andrey-belokon/NanoVFO_3/doc/as5600_encoder.png

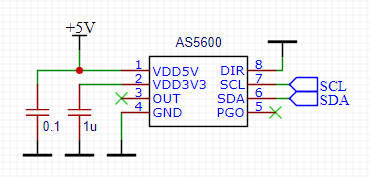
doc/as5600_encoder.png
