andrey-belokon/NanoVFO_3/doc/img/nanovfo3.2.new.jpg

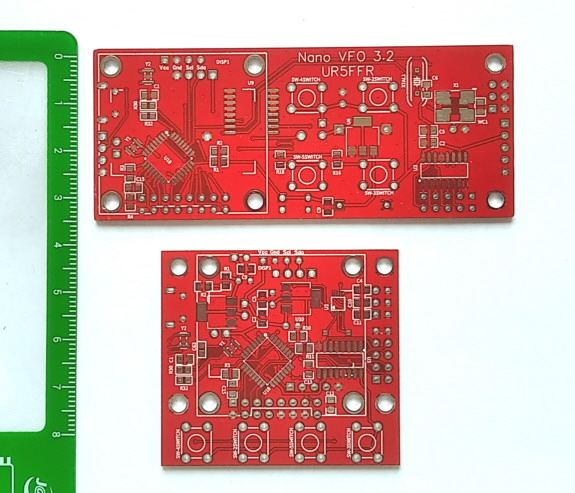
doc/img/nanovfo3.2.new.jpg
