andrey-belokon/NanoVFO_3/doc/img/nanovfo3_back.jpg

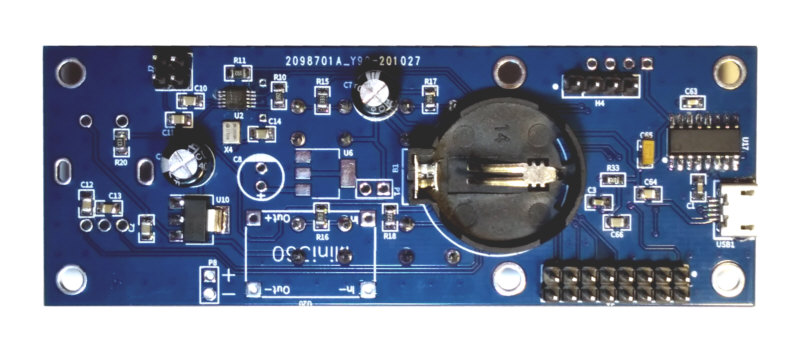
doc/img/nanovfo3_back.jpg
