andrey-belokon/NanoVFO_3/doc/img/nanovfo3_square_band_menu.jpg

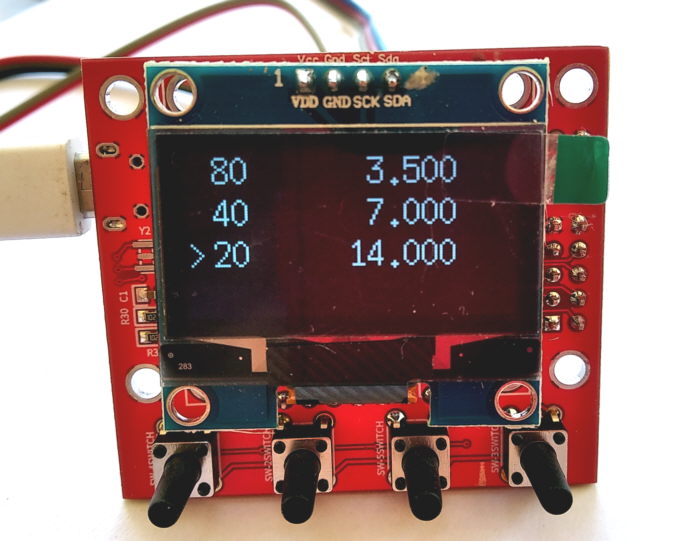
doc/img/nanovfo3_square_band_menu.jpg
