andrey-belokon/NanoVFO_3/doc/img/nanovfo3_square_pcb.jpg

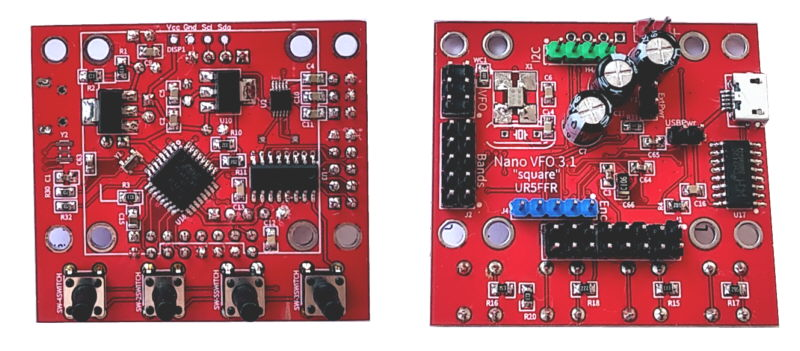
doc/img/nanovfo3_square_pcb.jpg
