andrey-belokon/NanoVFO_3/doc/img/nanovfo3_top.jpg

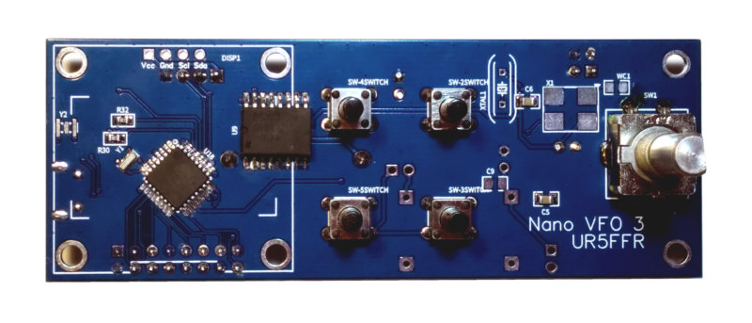
doc/img/nanovfo3_top.jpg
