andrey-belokon/NanoVFO_3/doc/img/nanovfo31_front.jpg

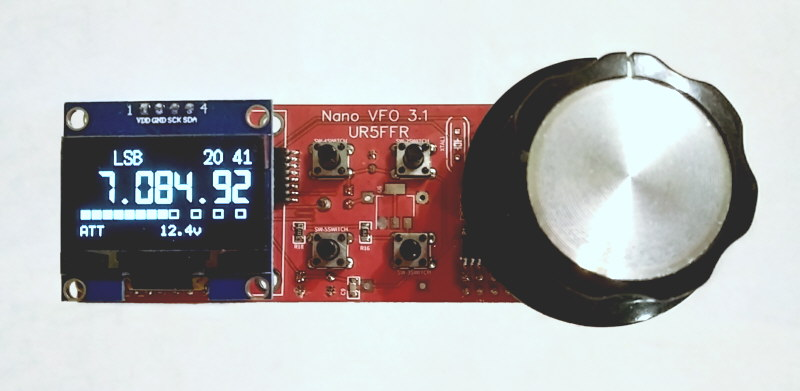
doc/img/nanovfo31_front.jpg
