andrey-belokon/NanoVFO_3/doc/Schematic_Nano VFO 3 SuperLED 2.png

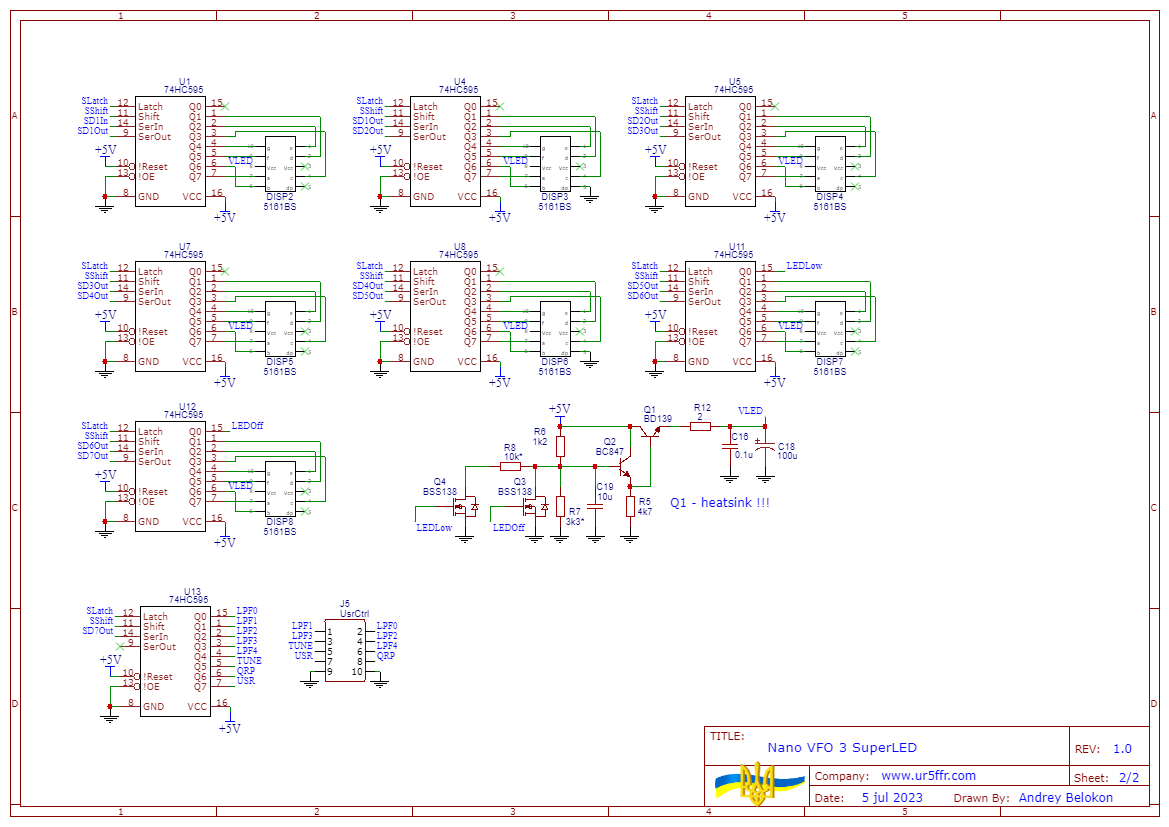
doc/Schematic_Nano VFO 3 SuperLED 2.png
