andrey-belokon/NanoVFO_3/doc/Schematic_Nano-VFO-3.1-square.png

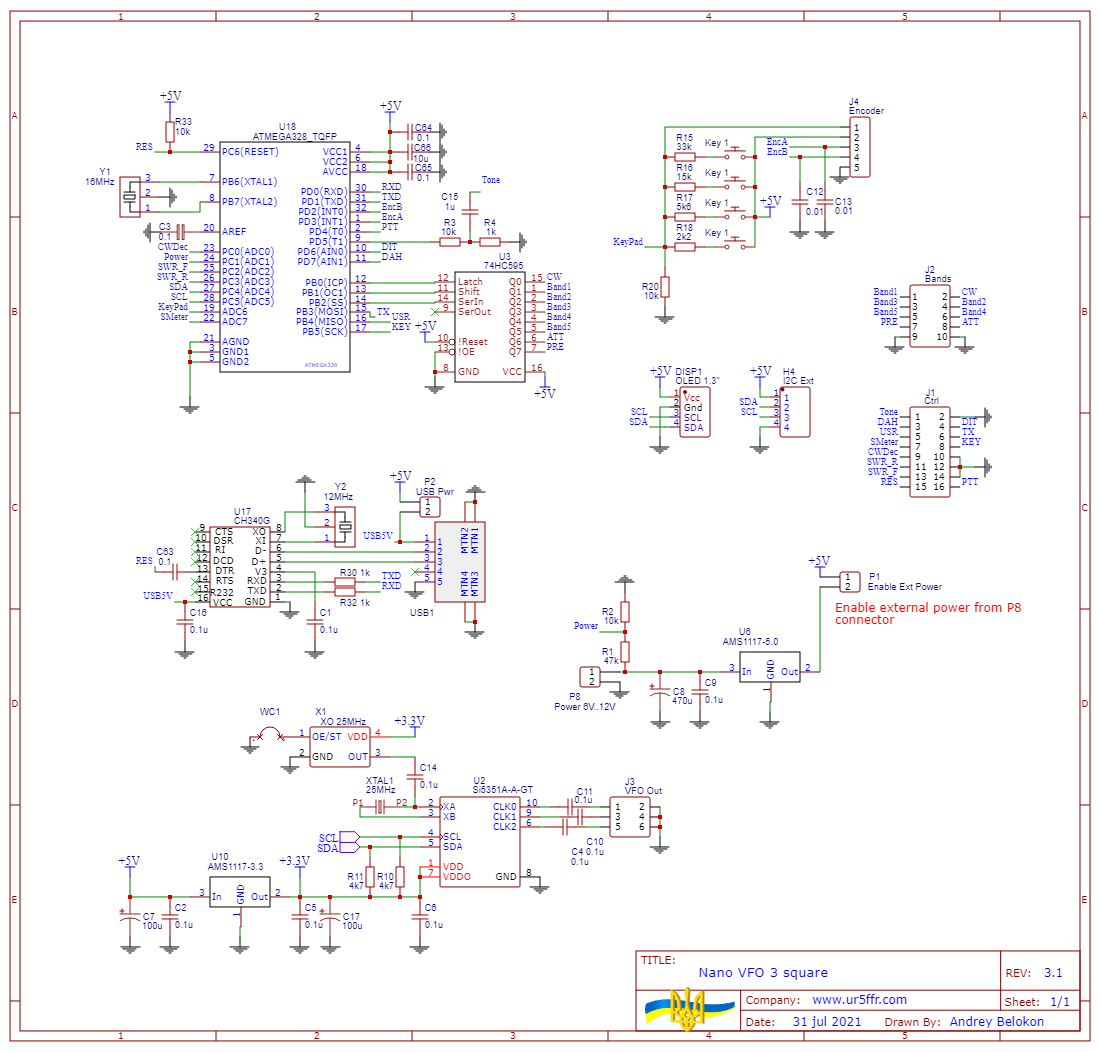
doc/Schematic_Nano-VFO-3.1-square.png
