andrey-belokon/NanoVFO_3/doc/Schematic_Nano-VFO-3.png

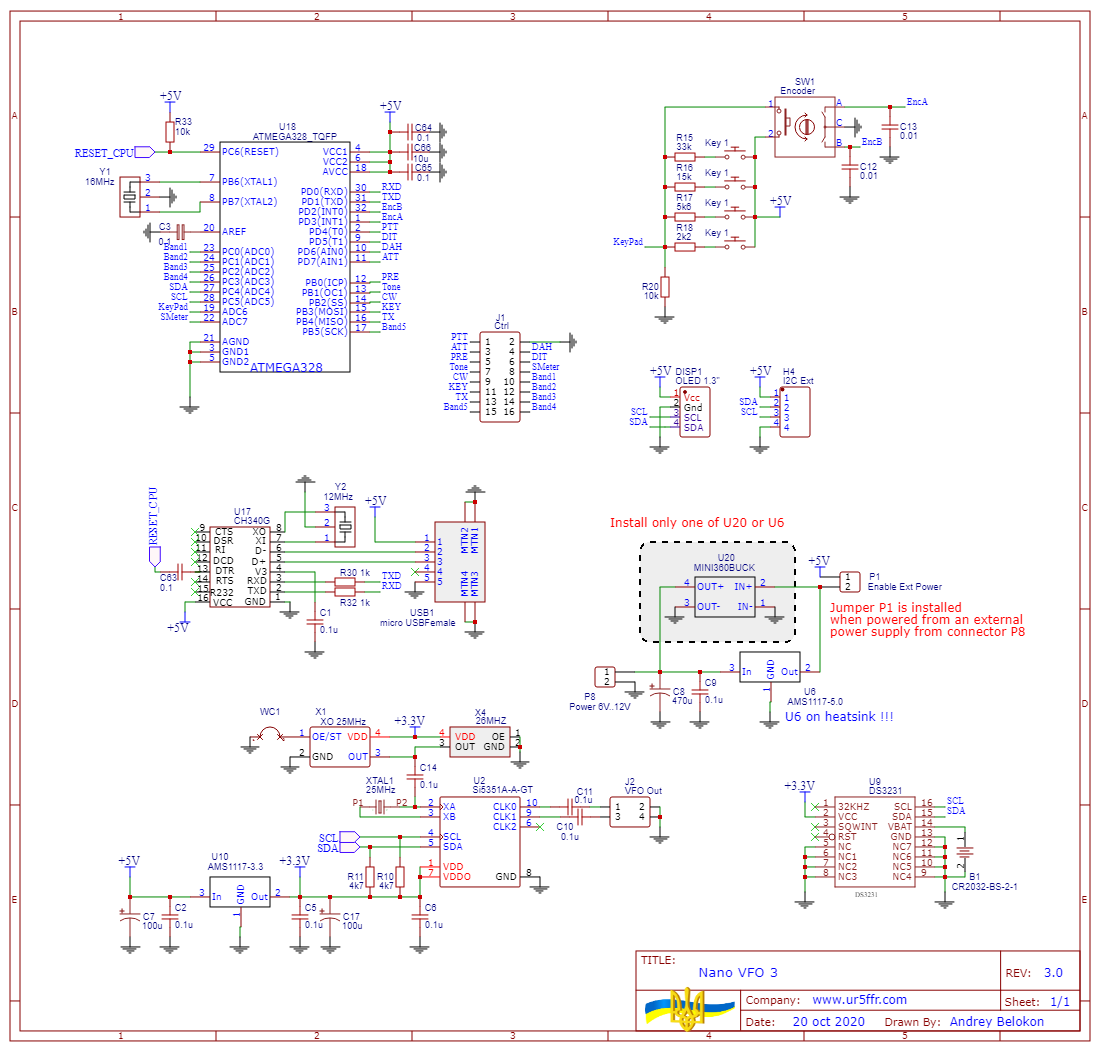
doc/Schematic_Nano-VFO-3.png
