andrey-belokon/NanoVFO_3/(threads)

Thread 1 (2022-12-13):

display doesn't start up

co6egm, 2022-12-13:
Hello! I'm trying to duplicate this VFO, but I noticed the display doesn't start on its own when unpower/power back on. I tried to upload an example just to initiate the display, then upload your sketch, and it works because the display is already initiated, but the issue appears when I shut down and power my Arduino back on. My test setup is just an arduino nano and the display properly wired.

co6egm, 2022-12-13:
solved after checking HW config file

Closed 2022-12-13.

Thread 2 (2023-11-17):

FT817 cat mode not working on WSTJ-X

rampa069, 2023-11-17:
FT817 is not working on WSTJ-X. Kenwood mode works ok, but cannot have SWR reading and kenwood mode (some extra bytes needed)

```
 Error Hamlib:
rig.c(1451):rig_open returning2(0)
 2:rig.c(3053):rig_get_vfo entered
rig_get_vfo: cache miss age=16059ms
 rig.c(3095) trace
ft817_get_vfo: called
ft817_read_eeprom: called
write_block(): TX 5 bytes, method=1
0000    00 55 00 00 bb                                      .U...   
read_block_generic called, direct=1
read_block_generic(1180): retrying read timeout 1/1 timeout=3000ms
0000    00                                                  .       
read_block_generic(): Timed out 6.46421 seconds after 1 chars, direct=1
Protocol error
)
 2:rig_get_vfo: elapsed=6053ms
 2:rig.c(3118):rig_get_vfo returning(-8) Protocol error

Protocol error
Protocol error
 mientras testing getting current VFO
```
