andrey-belokon/NanoVFO_3/doc/Schematic_Nano VFO 3 SuperLED.pdf

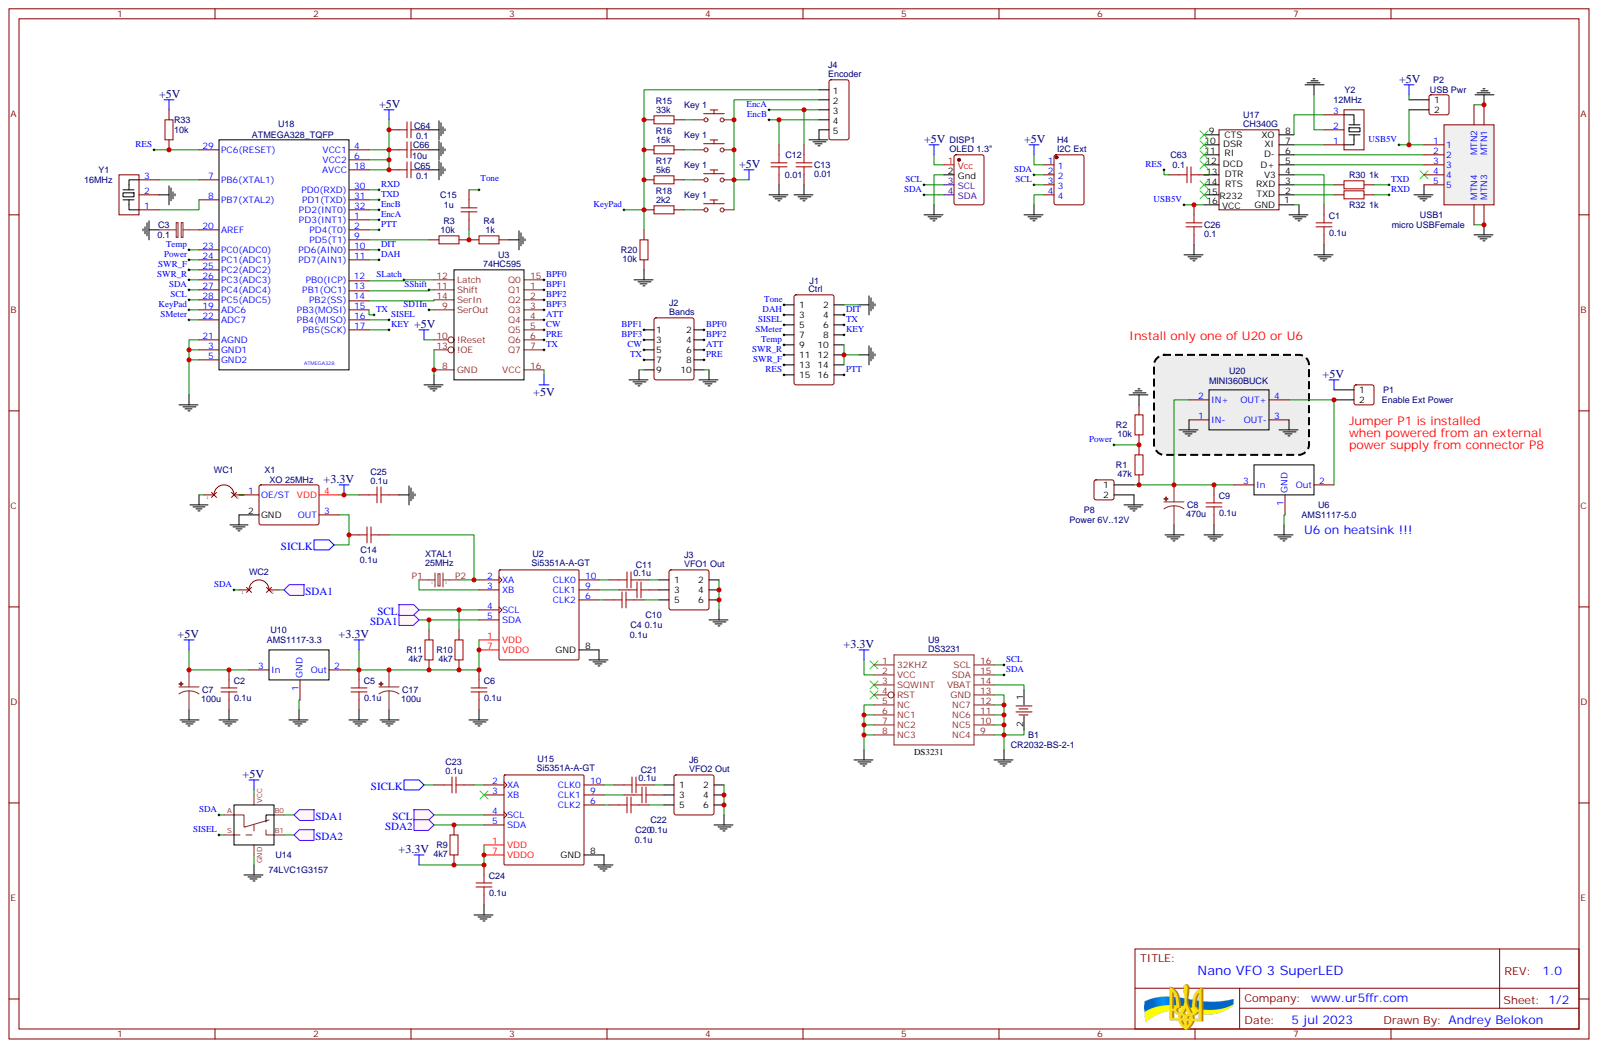
[picture p19: page 1]

Install only one of U20 or U6

Jumper P1 is installed
when powered from an external
power supply from connector P8

Drawn By: Andrey Belokon

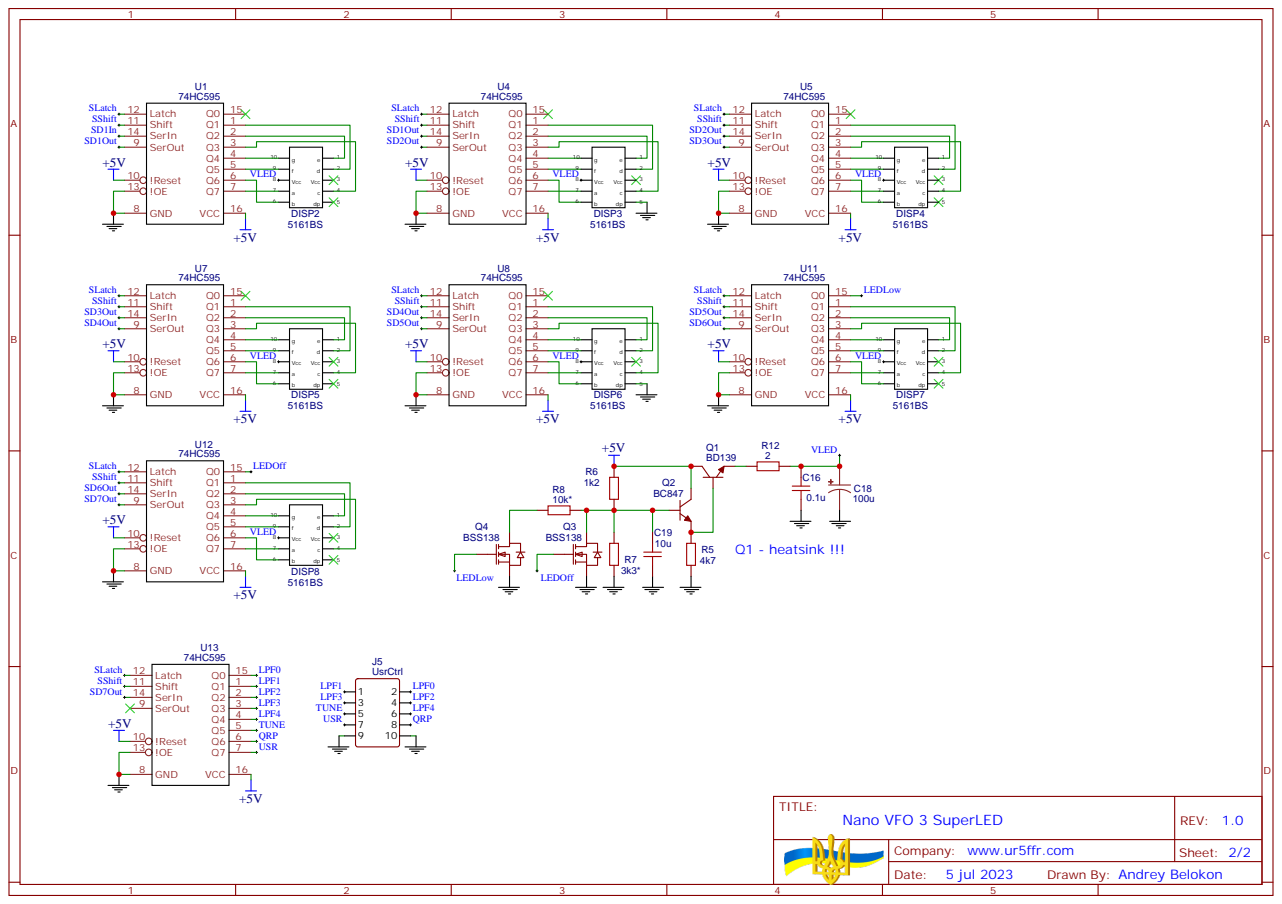
[picture p20: page 2]

Drawn By: Andrey Belokon
