andrey-belokon/NanoVFO_3/doc/Schematic_Nano-VFO-3.1-square.pdf

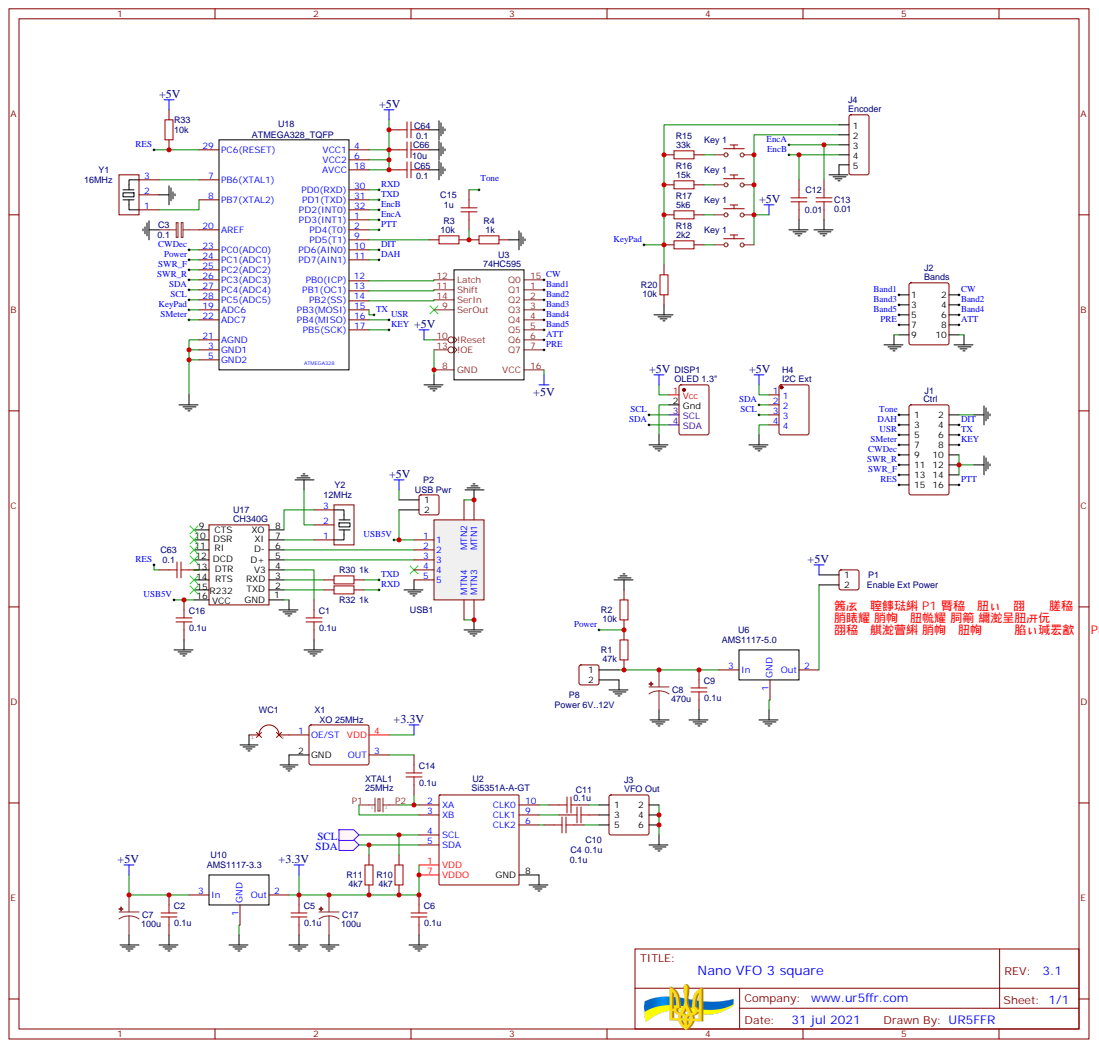
[picture p21: page 1]

Enable Ext Power
䇴㕄е䏄䭄琺䌀 P1 䐴䅄␰䏔ぃ␻䎄㉃е䐤䅄
䏴䁃耀 䏴㡄␰䏔㡃耀 䏤䈀 䌤㵃呈䏔㕃㐾
