andrey-belokon/NanoVFO_3/NanoVFO3/disp_OLED128x64.h

#ifndef DISP_OLED12864_H
#define DISP_OLED12864_H

#include <Arduino.h>
#include "TRX.h"

class Display_OLED128x64 {
  public:
	  void setup();
    // 1..15
    void setBright(uint8_t brightness);
	  void Draw(TRX& trx);
    void DrawItemEdit(PGM_P text, int value);
    void DrawItemValue(int value);
    void DrawItems(PGM_P* text, uint8_t selected);
    void DrawItemsValue(byte idx, int value, PGM_P sfx);
    void DrawSelected(uint8_t selected);
    void DrawFreqItems(TRX& trx, uint8_t idx, uint8_t selected);
    void DrawSMeterItems(PGM_P* text, const int* vals, uint8_t selected);
    #ifdef ENABLE_SWR_SENSOR
      void DrawSWRMeasureInit();
      void DrawSWRMeasure(int fval, int rval, int pwr = 0);
      void DrawSWRItemRaw(int fval, int rval);
    #endif
    void DrawText(bool visible, PGM_P text, uint8_t y);
    void BlinkText(PGM_P text);
    #ifdef ENABLE_INTERNAL_CWKEY
      void DrawCWBuf(TRX& trx);
    #endif
    #ifdef HARDWARE_3_1
      void DrawVCC(int rawdata, int vcc);
    #endif
    void clear();
};

#endif
