andrey-belokon/NanoVFO_3/(commit log)

2020-11-24 неточности в номиналах схемы
2020-11-24 не выставлялась частота в CAT
2021-03-05 Support for AS5600 encoder
2021-04-06 ошибка в определении PIN_OUT_BAND2
2021-07-03 Ошибка в коде формирования сигнала самоконтроля
2021-09-17 - RTC clock autodetect - band select menu - frequency granulation - selectable function for MEMO button - documentation - NanoVFO square
2021-11-01 AnalogRead bugfix in pins
    [pins.cpp]
2021-12-06 не формируется сигнал TX при передаче memo
2022-04-19 - Support FT-817 CAT protocol - add RX/TX switch (PTT) via CAT
2022-05-29 swr, power
2022-05-29 power on tx
